odddollar/Hertz-hunter/main/pins.h

#ifndef PINS_H
#define PINS_H

#define PREVIOUS_BUTTON_PIN 21
#define SELECT_BUTTON_PIN 20
#define NEXT_BUTTON_PIN 10

#define SPI_DATA_PIN 6
#define SPI_LE_PIN 7
#define SPI_CLK_PIN 4

#define RSSI_PIN 3

#define BUZZER_PIN 2

#define BATTERY_PIN 0

#endif
