odddollar/Hertz-hunter/main/bitmaps.h

#ifndef BITMAPS_H
#define BITMAPS_H

#include <Arduino.h>

// "Blank", 14x14px
const unsigned char bitmap_Blank[] PROGMEM = {
  0x00, 0x00, 0x00, 0x00, 0x00, 0x00, 0x00, 0x00, 0x00, 0x00, 0x00, 0x00, 0x00, 0x00, 0x00, 0x00,
  0x00, 0x00, 0x00, 0x00, 0x00, 0x00, 0x00, 0x00, 0x00, 0x00, 0x00, 0x00
};

// "Scan", 14x14px
const unsigned char bitmap_Scan[] PROGMEM = {
  0x00, 0x00, 0x00, 0x30, 0x00, 0x30, 0x00, 0x30, 0x00, 0x33, 0x00, 0x33, 0x00, 0x33, 0x30, 0x33,
  0x30, 0x33, 0x30, 0x33, 0x33, 0x33, 0x33, 0x33, 0x33, 0x33, 0x00, 0x00
};

// "Wifi", 14x14px
const unsigned char bitmap_Wifi[] PROGMEM = {
  0x00, 0x00, 0x00, 0x00, 0xf8, 0x07, 0x04, 0x08, 0x02, 0x10, 0xf1, 0x23, 0x08, 0x04, 0x04, 0x08,
  0xe0, 0x01, 0x10, 0x02, 0x00, 0x00, 0xc0, 0x00, 0xc0, 0x00, 0x00, 0x00
};

// "WifiLow", 14x14px
const unsigned char bitmap_WifiLow[] PROGMEM = {
  0x00, 0x00, 0x00, 0x00, 0x00, 0x00, 0x00, 0x00, 0x00, 0x00, 0x00, 0x00, 0x00, 0x00, 0x00, 0x00,
  0xe0, 0x01, 0x10, 0x02, 0x00, 0x00, 0xc0, 0x00, 0xc0, 0x00, 0x00, 0x00
};

// "Settings", 14x14px
const unsigned char bitmap_Settings[] PROGMEM = {
  0xc4, 0x08, 0x2a, 0x15, 0x31, 0x23, 0x02, 0x10, 0x04, 0x08, 0xc6, 0x18, 0xe1, 0x21, 0xe1, 0x21,
  0xc6, 0x18, 0x04, 0x08, 0x02, 0x10, 0x31, 0x23, 0x2a, 0x15, 0xc4, 0x08
};

// "About", 14x14px
const unsigned char bitmap_About[] PROGMEM = {
  0xe0, 0x01, 0x18, 0x06, 0x04, 0x08, 0xc2, 0x10, 0xc2, 0x10, 0x01, 0x20, 0x01, 0x20, 0xc1, 0x20,
  0xc1, 0x20, 0xc2, 0x10, 0xc2, 0x10, 0x04, 0x08, 0x18, 0x06, 0xe0, 0x01
};

// "Interval", 14x14px
const unsigned char bitmap_Interval[] PROGMEM = {
  0x00, 0x00, 0x00, 0x00, 0x33, 0x00, 0x33, 0x00, 0x33, 0x3f, 0x33, 0x3f, 0x3f, 0x30, 0x3f, 0x18,
  0x33, 0x0c, 0x33, 0x06, 0x33, 0x3f, 0x33, 0x3f, 0x00, 0x00, 0x00, 0x00
};

// "Buzzer", 14x14px
const unsigned char bitmap_Buzzer[] PROGMEM = {
  0x00, 0x00, 0x30, 0x04, 0x28, 0x08, 0x24, 0x11, 0x23, 0x22, 0x23, 0x24, 0x23, 0x24, 0x23, 0x24,
  0x23, 0x24, 0x23, 0x22, 0x24, 0x11, 0x28, 0x08, 0x30, 0x04, 0x00, 0x00
};

// "Alarm", 14x14px
const unsigned char bitmap_Alarm[] PROGMEM = {
  0xe0, 0x01, 0x00, 0x06, 0x04, 0x08, 0x08, 0x10, 0x10, 0x12, 0x21, 0x21, 0xc1, 0x20, 0xc1, 0x20,
  0x01, 0x20, 0x02, 0x10, 0x02, 0x10, 0x04, 0x08, 0x18, 0x06, 0xe0, 0x01
};

// "Selected", 14x14px
const unsigned char bitmap_Selected[] PROGMEM = {
  0x80, 0x00, 0x42, 0x10, 0x84, 0x08, 0x48, 0x04, 0xf0, 0x03, 0x10, 0x02, 0xd5, 0x16, 0xda, 0x2a,
  0x10, 0x02, 0xf0, 0x03, 0x88, 0x04, 0x44, 0x08, 0x82, 0x10, 0x40, 0x00
};

// "Calibration", 14x14px
const unsigned char bitmap_Calibration[] PROGMEM = {
  0xf0, 0x03, 0x08, 0x04, 0x04, 0x08, 0xe2, 0x11, 0x11, 0x22, 0x09, 0x24, 0xc9, 0x24, 0xc9, 0x24,
  0x09, 0x24, 0x11, 0x22, 0xe2, 0x11, 0x04, 0x08, 0x08, 0x04, 0xf0, 0x03
};

// "Serial", 14x14px
const unsigned char bitmap_Serial[] PROGMEM = {
  0x00, 0x0e, 0x00, 0x0e, 0x08, 0x0e, 0x1c, 0x0e, 0x3e, 0x0e, 0x7f, 0x0e, 0x1c, 0x0e, 0x1c, 0x0e,
  0x9c, 0x3f, 0x1c, 0x1f, 0x1c, 0x0e, 0x1c, 0x04, 0x1c, 0x00, 0x1c, 0x00
};

#endif
