odddollar/Hertz-hunter/main/api.h

#ifndef API_H
#define API_H

#include <Arduino.h>
#include <ArduinoJson.h>
#include <ESPAsyncWebServer.h>
#include <WiFi.h>
#include "battery.h"
#include "RX5808.h"
#include "settings.h"

#define WIFI_SSID "Hertz Hunter"
#define WIFI_PASSWORD "hertzhunter"
#define WIFI_IP "192.168.4.1"
#define WIFI_GATEWAY WIFI_IP
#define WIFI_SUBNET "255.255.255.0"

// Holds state and responses for wifi and api
class Api {
public:
#ifdef BATTERY_MONITORING
  Api(Settings *s, RX5808 *r, Battery *b);
#else
  Api(Settings *s, RX5808 *r);
#endif
  void startWifi();
  void stopWifi();

private:
  void handleNotFound(AsyncWebServerRequest *request);
  void handleGetValues(AsyncWebServerRequest *request);
  void handlePostValues(AsyncWebServerRequest *request, uint8_t *data, size_t len, size_t index, size_t total);
  void handleGetSettings(AsyncWebServerRequest *request);
  void handlePostSettings(AsyncWebServerRequest *request, uint8_t *data, size_t len, size_t index, size_t total);
  void handleGetCalibration(AsyncWebServerRequest *request);
  void handlePostCalibration(AsyncWebServerRequest *request, uint8_t *data, size_t len, size_t index, size_t total);
#ifdef BATTERY_MONITORING
  void handleGetBattery(AsyncWebServerRequest *request);
#endif

  bool wifiOn;

  AsyncWebServer server;

  Settings *settings;
  RX5808 *receiver;
#ifdef BATTERY_MONITORING
  Battery *battery;
#endif
};

#endif
