odddollar/Hertz-hunter/main_rewrite/battery.h

#ifndef BATTERY_H
#define BATTERY_H

#include <Arduino.h>
#include "settings.h"
#include "variable.h"

#define BATTERY_VOLTAGE_OFFSET 1
#define MIN_LOW_BATTERY_TIME 1000

// Battery monitoring for battery module
// Maintains internal store of current voltage
class Battery {
public:
  Battery(uint8_t p, Settings* s);
  void updateBatteryVoltage();
  bool lowBattery();

  VariableRestricted<int> currentVoltage;

private:
  uint8_t pin;
  
  unsigned long lastLowBatteryTime;

  Settings* settings;
};

#endif
