odddollar/Hertz-hunter/(commit log)

2025-02-20 Added battery alarm icon
2025-02-20 Added calibration menu
2025-02-22 Removed serial debug printing
2025-02-25 Not working RX5808 frequency setting
    [RX5808.cpp, RX5808.h]
2025-02-26 Working rssi reading and channel switching
2025-02-26 Fixed interval 5 bug and graph bar width
    [RX5808.cpp, menu.cpp]
2025-02-26 Removed wires text from readme
2025-02-27 Loop now uses switches instead of ifs
2025-02-27 Moved scanning to separate thread
2025-02-27 Decreased button debounce delay
2025-02-27 Fixed bar drawing bug
    [RX5808.cpp, menu.cpp]
2025-02-28 Passing calibration values to drawing function
2025-03-01 Added min and max rssi calibration
2025-03-02 Added calibration instructions to calibration menu
2025-03-02 Running buzzing in separate thread
    [buzzer.cpp]
2025-03-02 Added beeps on buttons presses
2025-03-03 Updating buzzer state based on settings
    [main.ino]
2025-03-03 Changed when select buzz occurs
    [main.ino, menu.cpp, menu.h]
2025-03-03 Changed calibration channel to F4
2025-03-03 Added battery voltage monitoring function
2025-03-03 Explicitly setting adc attenuation for safety
2025-03-05 Added battery voltage to main menu
2025-03-05 Inverting font colour for battery voltage
    [menu.cpp]
2025-03-05 Simplified battery reading method
2025-03-05 Added reset function by pressing all buttons
    [main.ino]
2025-03-05 Added checking battery alarm threshold
2025-03-05 Added timer to stop immediate low battery alarm
2025-03-05 Added alarm in separate thread
2025-03-05 Fixed continuous buzzing bug
    [main.ino]
2025-03-12 Added battery voltage offset
2025-03-18 Added wiring diagram
2025-03-19 Added flashing and battery calibration to readme
2025-03-20 Added rssi calibration section to readme
2025-05-06 Replaced calibration menu with advanced
    [main.ino, menu.cpp]
2025-05-06 Added menu tree for calibration and start wifi
2025-05-07 Use smaller font if wifi ip too long
    [menu.cpp]
2025-05-08 Added initial battery api endpoint
2025-05-08 Added api endpoint for getting calibration values
2025-05-10 Tidied up api comments and prints
2025-05-13 Fixed off by one text on about menu
    [menu.cpp]
2025-05-21 Added calibrated rssi to settings class
2025-05-22 Fixed writing settings to memory
    [main_rewrite.ino]
2025-05-22 Removed debug prints
2025-05-24 Added alarm function to buzzer
    [buzzer.cpp, buzzer.h]
2025-05-24 Added basic battery voltage monitoring
2025-05-24 Added low battery monitoring
2025-05-25 Added basic menu class and voltage to main menu
2025-05-28 Added button pins for menu
2025-05-28 Buzz on button press
    [main_rewrite.ino, menu.cpp, menu.h]
2025-05-28 Changed when battery voltage drawn
2025-05-28 Checking of select button for going back
2025-05-28 Passing battery object to menu object
2025-05-28 No longer passing battery object to menu
    [main_rewrite.ino, menu.cpp, menu.h]
2025-06-02 Added rssi calibration
2025-06-04 Added battery api endpoint
2025-06-04 Added calibration api endpoint
2025-06-10 Variable to keep track of low or high band
2025-06-10 Switching text between low and high bands
2025-06-10 Switching module frequency to lowband
2025-06-11 Added api endpoint for updating calibration
2025-06-12 Added post calibration documentation
2025-08-31 add rotary encoder functionality
2025-09-02 screen working. encoder works but needs debounce
2025-09-02 enable switches
2025-09-06 improve encoder accuracy
2025-09-29 Fixed api variable data type
    [api.cpp]
2025-11-02 Add reset functionality and return default screen back to main
    [menu.cpp]
2025-11-06 Formatted code and added buzzer on encoder turn
    [menu.cpp, menu.h]
2025-11-06 Added reference to encoder input support in readme
2025-11-25 Added ability to turn of battery voltage display
2025-11-25 Added alternate API constructor if not using battery
2025-11-25 Disabling battery api endpoint when monitoring disabled
2025-11-25 Added documentation for disabling battery monitoring
2025-11-25 Hiding battery alarm settings if monitoring disabled
2025-12-31 Reordered wifi and calibration menus
2026-01-03 Fixed battery mutexes
2026-01-17 Added get battery endpoint
2026-01-17 Added get calibration endpoint
2026-01-17 Fixed battery in settings when option disabled
    [api.cpp]
2026-01-18 Added post calibration endpoint
2026-01-18 Added location data to error messages
    [usb.h]
2026-01-21 Fixed post calibration bug
2026-01-21 Standardised error and success formats
    [bitmaps.h]
2026-01-29 Added dot points to disable battery list about usb serial
2026-03-28 Fixed stop scanning mutex deadlock
    [RX5808.cpp, RX5808.h]
2026-04-16 Added note on manually setting calibration values with usb client
2026-07-24 Fixed stopping services on different menus
    [menu.cpp]
2026-07-24 Minor comment consistency fixes
    [api.cpp, menu.cpp, settings.h]
2026-07-24 Preventing calling set where not supposed to
    [RX5808.cpp, RX5808.h, api.cpp, battery.h, menu.cpp, settings.h]
2026-07-24 Clamping array get
2026-07-24 Small scan stop/start requirement comment fix
    [RX5808.cpp]
2026-07-29 Clamping array set index
2026-07-29 Can't have empty payload for api post settings and calibration
2026-07-31 Changed error message on empty body
    [api.cpp]
